UniversalScientificTechnologies/LABDOS01/fw/LABDOS/README.md

# Loading compiled binaries to MCU

## Avrdude

In case of using the avrdude and mightyCore bootloader we should use following command:

```
avrdude -v -patmega1284p -carduino -P/dev/ttyUSB0 -b115200 -D -Uflash:w:./build/MightyCore.avr.1284/LABDOS.ino.hex:i
```
