UniversalScientificTechnologies/LABDOS01/notebooks/spectrum_labdos.csv

 | energy | count
10 | 0.0429 | 21.074836950514023
11 | 0.0572 | 25.27985555842146
12 | 0.07150000000000001 | 45.40093592247319
13 | 0.08580000000000002 | 42.0720733999042
14 | 0.1001 | 34.35049191200855
15 | 0.1144 | 22.5532259847452
16 | 0.1287 | 17.705516047017205
17 | 0.14300000000000002 | 12.71056413279782
18 | 0.15730000000000002 | 9.889752754338774
19 | 0.1716 | 7.761376616677108
20 | 0.1859 | 7.25995799403073
21 | 0.20020000000000002 | 6.422270533181031
22 | 0.2145 | 5.119643317734626
23 | 0.2288 | 4.213640885810088
24 | 0.2431 | 4.372158148789564
25 | 0.2574 | 3.6525295699915254
26 | 0.2717 | 3.2817716201776044
27 | 0.286 | 2.7584656767014257
28 | 0.3003 | 2.816831865580898
29 | 0.3146 | 2.259036810494123
30 | 0.32889999999999997 | 2.2855668963484286
31 | 0.3432 | 1.8577692619477506
32 | 0.3575 | 1.7735362393603298
33 | 0.37179999999999996 | 1.5513467703305208
34 | 0.3861 | 1.4385939054497219
35 | 0.4004 | 1.2250267143225615
36 | 0.41469999999999996 | 1.1878845941265337
37 | 0.429 | 1.0612034341722245
38 | 0.44329999999999997 | 0.9623788643649361
39 | 0.4576 | 0.7992188363609566
40 | 0.4719 | 0.8025350970927447
41 | 0.48619999999999997 | 0.661925642064925
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
