UniversalScientificTechnologies/LABDOS01/notebooks/spectrum_tpx.csv

 | energy | count
0 | 0.01430052 | 19.723074776785715
1 | 0.028613320020491804 | 13.896271076224913
2 | 0.042926120040983604 | 10.928535686614524
3 | 0.05723892006147541 | 11.091536304604489
4 | 0.07155172008196722 | 20.277651592015943
5 | 0.08586452010245903 | 32.50644508190673
6 | 0.10017732012295082 | 32.99732050619835
7 | 0.11449012014344262 | 27.015634992375052
8 | 0.12880292016393444 | 20.348222740800868
9 | 0.14311572018442623 | 15.48943037313066
10 | 0.15742852020491804 | 12.155099723902993
11 | 0.17174132022540986 | 9.404698491612557
12 | 0.18605412024590162 | 7.645415959513972
13 | 0.20036692026639344 | 6.439461195764464
14 | 0.21467972028688526 | 5.36777897173849
15 | 0.22899252030737705 | 4.550277788026368
16 | 0.24330532032786886 | 3.9501107616341993
17 | 0.2576181203483607 | 3.476097470238096
18 | 0.27193092036885247 | 2.985222045946478
19 | 0.28624372038934426 | 2.662343427169422
20 | 0.3005565204098361 | 2.3013688785173163
21 | 0.3148693204303279 | 2.13399659644333
22 | 0.3291821204508197 | 1.884187220213499
23 | 0.3434949204713115 | 1.7236846959858325
24 | 0.35780772049180326 | 1.4944845932949629
25 | 0.37212052051229505 | 1.3439744441164898
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
