UniversalScientificTechnologies/LABDOS01/doc/EOSR7032-Edit.jpg

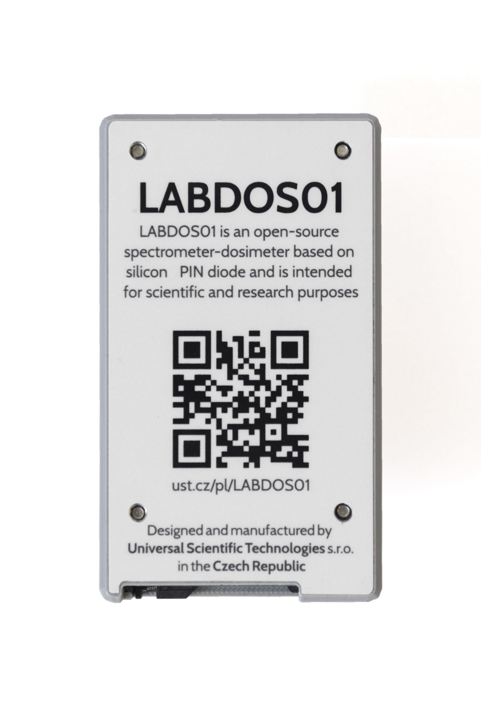
doc/EOSR7032-Edit.jpg
