UniversalScientificTechnologies/LABDOS01/doc/EOSR7036-Edit.jpg

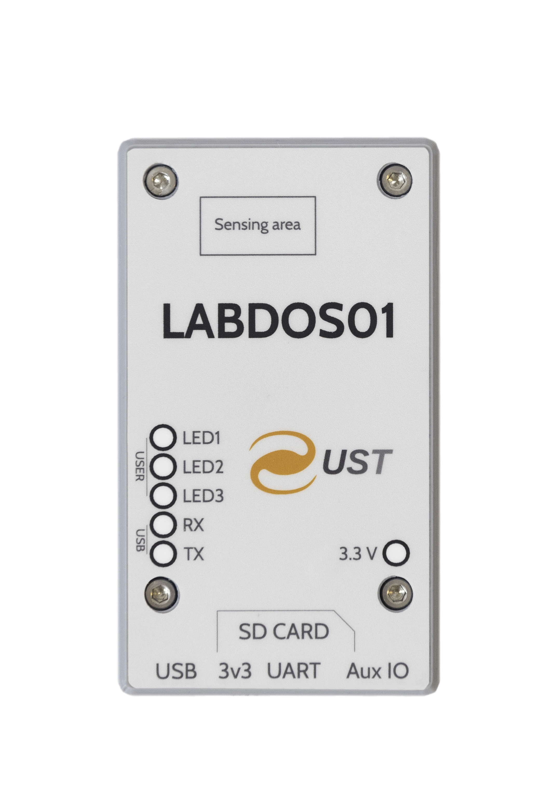
doc/EOSR7036-Edit.jpg
