UniversalScientificTechnologies/LABDOS01/doc/img/LABDOS01_cockpit.jpg

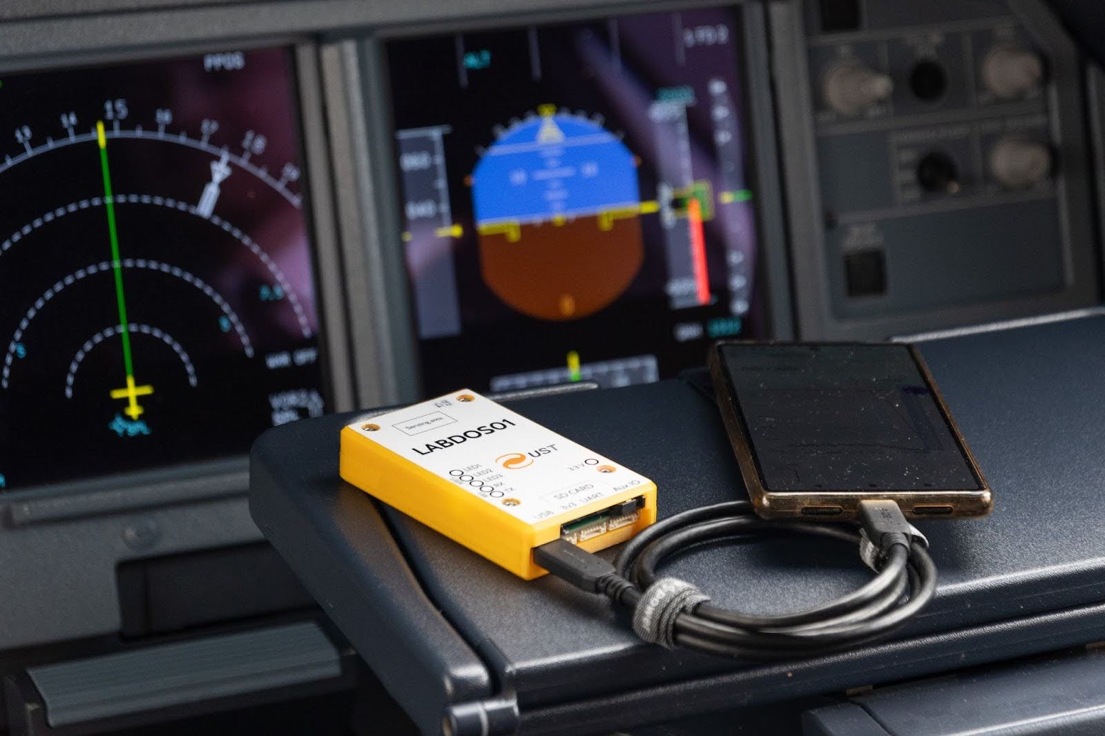
doc/img/LABDOS01_cockpit.jpg
