UniversalScientificTechnologies/LABDOS01/doc/LABDOS01A_merge.jpg

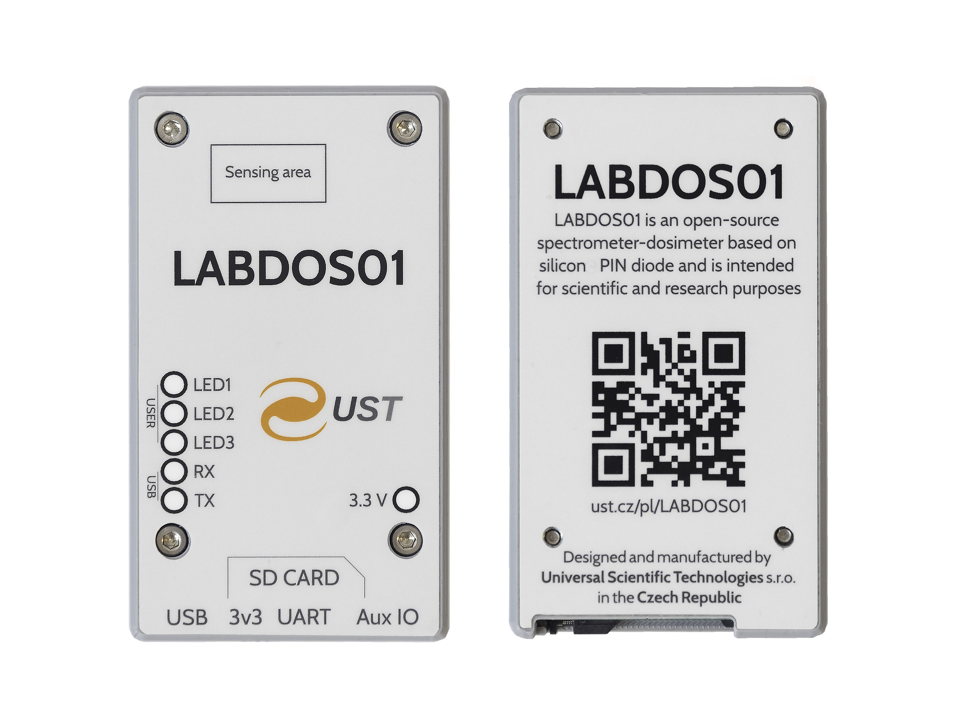
doc/LABDOS01A_merge.jpg
