UniversalScientificTechnologies/LABDOS01/cad/slice/case.3mf

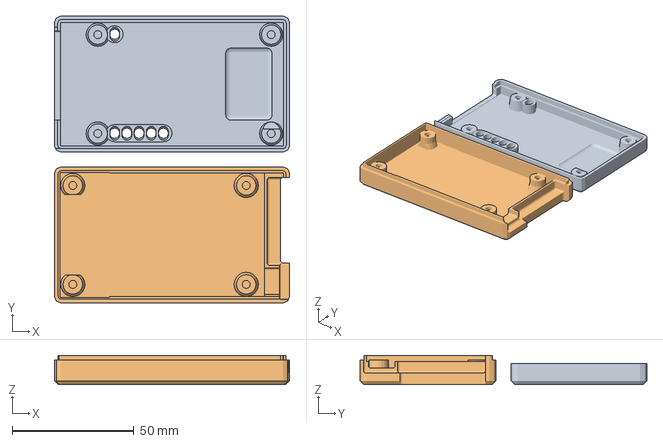
[picture p10: CAD file, 2023-12-08]
cad/slice/case.3mf
96.5 x 117.7 x 12.1 mm
case_top.stl
case_bot.stl
