UniversalScientificTechnologies/LABDOS01/cad/stl/case_top.stl

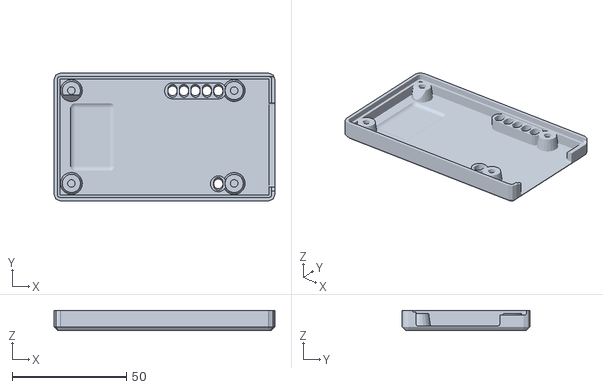
[picture p11: CAD file, 2023-04-22]
cad/stl/case_top.stl
96.5 x 55.8 x 8.76
