UniversalScientificTechnologies/LABDOS01/cad/slice/case_2x.3mf

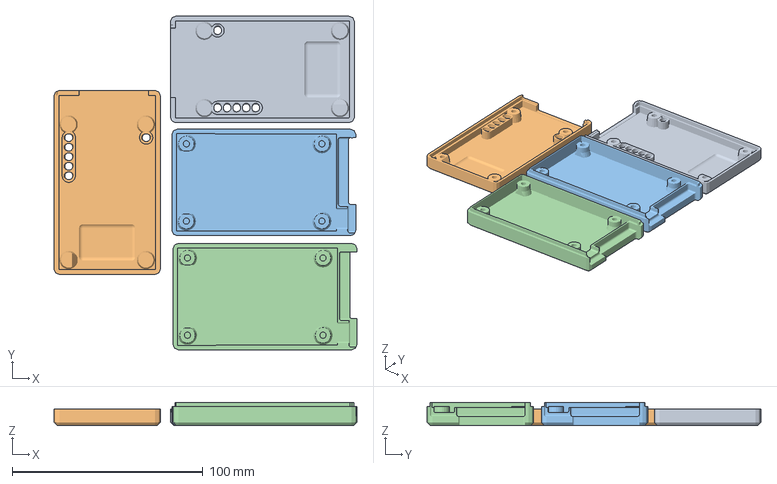
[picture p12: CAD file, 2023-04-22]
cad/slice/case_2x.3mf
159.0 x 175.0 x 12.1 mm
case_top.stl
case_bot.stl
