UniversalScientificTechnologies/LABDOS01/cad/stl/case_bot.stl

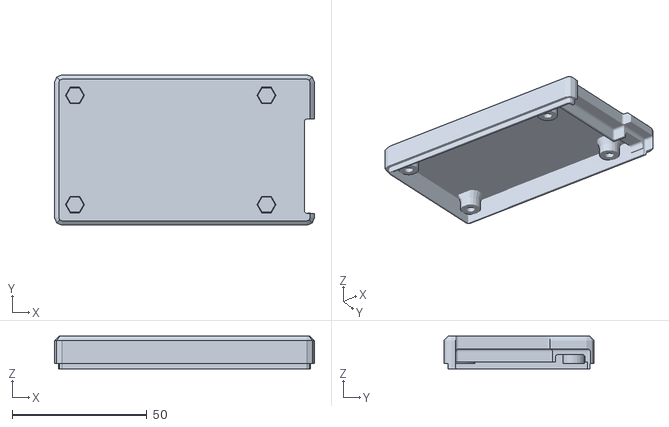
[picture p13: CAD file, 2023-04-22]
cad/stl/case_bot.stl
96.5 x 55.8 x 12.1
