UniversalScientificTechnologies/LABDOS01/cad/src/case_bot.scad

use <LABDOS01_case.scad>
rotate([180, 0, 0]) bot();
