UniversalScientificTechnologies/LABDOS01/cad/src/case_label_border.scad

use <LABDOS01_case.scad>

label();

translate([0, 70, 0]) label2();
