UniversalScientificTechnologies/LABDOS01/cad/src/case_top.scad

use <LABDOS01_case.scad>
rotate([180, 0, 0]) top();
