UniversalScientificTechnologies/LABDOS01/doc/calibration.ods

Sheet: Sheet1
 | LABDOS calibration |  | 1 pF | 3 pF | 4 pF | 5 pF
 | s.n. 7e
 |  |  |  |  | +-23 keV
C [F] | U [mV] | Q [C] | N_e | E [eV] | E [MeV] | ch |  | ch zaric | E zaric [MeV] |  |  | ch width
1.01E-12 | 239 | 2.4139E-13 | 1506803.99500624 | 5499834.58177278 | 5.49983458177278 | 201 | Am-241 | 201.5 | 5.486 | 0.329 | 14 | 0.0235
e [C] | 225 | 2.2725E-13 | 1418539.3258427 | 5177668.53932584 | 5.17766853932584 | 190 | Pu-239 | 190 | 5.157
1.60E-19 | 3.2 | 3.232E-15 | 20174.7815230961 | 73637.9525593009 | 0.0736379525593009 | 3
E_e-h | 3.1 | 3.131E-15 | 19544.3196004994 | 71336.7665418227 | 0.0713367665418227 | 3
3.65 | 253 | 2.5553E-13 | 1595068.66416979 | 5822000.62421973 | 5.82200062421973 | 207 | saturace
 | 239 | 2.4139E-13 | 1506803.99500624 | 5499834.58177278 | 5.49983458177278 | 97
 | 239 | 2.4139E-13 | 1506803.99500624 | 5499834.58177278 | 5.49983458177278 | 78
 | 624 | 6.3024E-13 | 3934082.39700375 | 14359400.7490637 | 14.3594007490637 | 207 | saturace
 | 730 | 7.373E-13 | 4602372.0349563 | 16798657.9275905 | 16.7986579275905 | 207 | saturace
 | 6.3 | 6.363E-15 | 39719.1011235955 | 144974.719101124 | 0.144974719101124 | 2
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
