UniversalScientificTechnologies/LABDOS01/(threads)

Thread 5 (2022-07-27):

Typo in bottom box sticker

kaklik, 2022-07-27:
There is accidentally [silicone](https://en.wikipedia.org/wiki/Silicone) instead of [silicon](https://en.wikipedia.org/wiki/Silicon):

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

At the same time, I suggest updating the text to describe better form: "LABDOS01 is an open-source spectrometer-dosimeter based on silicon PIN diode and is intended for scientific research and experimental purposes. "

roman-dvorak, 2022-09-26:
V návrhu samolepek opraveno:

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

Zároveň vyretušováno na všech fotkách v repozitáři.

Closed 2022-09-26.

Thread 6 (2022-10-20):

Design consistency

kaklik, 2022-10-20:
Současné řešení je navrženo tak moc "univerzálně", že některé jeho vlastnosti nelze využít. Například JST-GH konektor původně určený pro bateriové napájení je obtížně použitelný.
Zároveň je zde příprava pro připojení [TFGPS01](https://github.com/ThunderFly-aerospace/TFGPS01), která ale nejde použít jinak než s powerbankou, která má dva napájecí konektory.  Příčinou je, že LABDOS zároveň předpokládá použití jako payloadu pro UAV. V takové aplikaci se pak předpokládá, že GPS bude napájena z jiného zdroje.
UART konektor je proto chráněn diodou tak, aby se na něj nemohlo dostat napájecí napětí z případně zapojeného USB konektoru, což by způsobilo nechtěné napájení celého UAV systému. USB konektor je ale na LABDOSu podstatný proto, aby zařízení mohlo být kompaktní a snadno použitelné pro různé laboratorní aplikace.

Z těchto důvodů bych navrhoval použití LABDOSu jako UAV payloadu zrušit a tuto vlastnost pokrýt [původně zamýšlenou úpravou SPACEDOS02](https://github.com/UniversalScientificTechnologies/SPACEDOS02/issues), který nemá mít USB konektor a konektor pro napájení z baterie. Tyto dva konektory jsou příčinou zmíněných komplikací.

Naopak dává smysl současnou dvojici UART konektoru a "bateriového napájecího konektoru" na LABDOSu nahradit [Autopilot GPS&SAFETY connectorem](https://github.com/ThunderFly-aerospace/TFGPS01#autopilot-gpssafety-connector). Což umožní připojit TFGPS stejně jako se připojuje k autopilotu, což kromě napájení umožní i další možnosti:

- Připojení externího pípáku z TFGPS
- Připojení tlačítka
- Připojení výstupu z GPS
- Možnost připojení nějakých podpůrných čidel na I2C sběrnici.

Na zvážení je také odebrání pouzdra pro SDkartu, které v zařízení, které je napájeno z USB konektoru připojeného do nadřazeného systému nedává úplně smysl.
Taktéž RTC obvod a jeho baterie asi nedává smysl.

Thread 7 (2022-10-21):

Sticker screw hole possitions

kaklik, 2022-10-21:
Samolepky se při skladování zřejmě scvrkly a otvory na hlavičky šroubů nyní nepasují přesně na šrouby. Tím dochází k zakrývání hlaviček šrubů.
Podezřelé ale je, že se tento problém zřejmě vyskytuje už od nových samolepek. Před výrobou dalších je třeba ověřit, že otvory výřezů pro šrouby z vrchní strany jsou skutečně správně umístěny.

roman-dvorak, 2022-10-21:
z PDF návrhu jsem změřil, že rozteč otvorů na šrouby v horní vrstvě je:

 * 71,122 mm  ->  10.16*7 je 71.2
 * 40.59 mm  ->  10.16*4 je 40.64

Bylo by zajímavé porovnat vzdálenosti otvorů od kraje samolepky.

Pozice děr vznikla způsobem, že jsem z openscadu si vytvořil projekci
krabičky a ta byla vzata jako obrys pro samolepku.
Message ID: ***@***.***

>

kaklik, 2022-11-11:
Zřejmě to tak není problém návrhu ale výroby samolepky..

Thread 9 (2023-01-20):

Reset button

kaklik, 2023-01-20:
Pro experimenty s firmwarem je celkem podstatné mít možnost číst  data na sériové lince od okamžiku spuštění MCU. U LABDOSu s připojením na USB, se to ale těžko dělá, protože MCU dovede zapisovat data do virtuálního USB serial ještě dříve, než se zinicializuje.

Řešením tohoto problému by bylo přidání resetovacího tlačítka, které lze zmáčknout otvorem v krabičce pomocí nějakého nástroje.

kaklik, 2023-01-23:
Altenrantivním řešením může být zatahání za DTR. Například picocom by to měl umět pomocí klávesových zkratek Ctrl+A Ctrl+P.

Thread 11 (2023-02-17):

Merge the firmware variants to streamline codebase

kaklik, 2023-02-17:
Současný firmware má několik různých variant, které se jen minimálně liší:

- Počtem kanálů 256/512
- Jestli má nebo nemá SDkartu pro zápis
- Frekvencí použitého krystalu

U těchto rozdílů zřejmě neexistuje důvod proč držet různé codebase.  Zádrhelem je akorát to, že by bylo potřeba implementovat přepínací vlastnosti firmware (což je ale stejně potřeba kvůli integračnímu intervalu). Tyto parametry jsou buď nastaveny při překladu (frekvence krystalu), nebo jsou parametrem přístroje (počet kanálů, integrační doba, zápis na SDkartu...)

Parametry přístroje by zřejmě správně měly být zapisovány do externí EEPROM, aby nebyly přepsány aktualizací firmware.

-------
**Poznámka k počtu kanálů**
Původní verze detektoru měla pouze 256 kanálů jako liulin.  Zvětšení počtu kanálů podle @kakl  vedlo na problem, ze ta ATmega ma nejakou proprietarni kompenzaci DC offsetu. Díky tomu interní ADC nefunguje dobře s externí referencí a způsobuje to jitter kanálů na spektrogramu. https://github.com/UniversalScientificTechnologies/LABDOS01/issues/15

Počet kanálů by ale obecně potřeboval zvýšit viz https://github.com/UniversalScientificTechnologies/GEODOS01/issues/23 Tudíž je zřejmě nutné začít používat externí ADC.

kaklik, 2023-04-21:
Tohle bylo provedeno až na firmware pro "UAVDOS", který zde zatím zůstal.

Closed 2023-04-21.

Thread 13 (2023-02-17):

Dead time minimalization

kaklik, 2023-02-17:
Aktuální implementace minimalizuje mrtvou měřící dobu tím způsobem, že hromadí co nejvíce dat v operační paměti a z nich pak vytvoří datovou zprávu kterou buď rychle odešle na UART, nebo [uloží na SDkartu](https://github.com/UniversalScientificTechnologies/GEODOS01/issues/24).

Takový přístup je do značné míry suboptimální, protože jednak neminimalizuje mrtvou dobu měření úplně a zároveň ji prodlužuje na těžko definovanou dobu, která závisí na měřených datech.

Navíc to komplikuje zacházení s formátem výstupních dat https://github.com/UniversalScientificTechnologies/LABDOS01/issues/12

Teoreticky by ale mrtvou dobu mělo jít výrazně omezit vhodnou obsluhou UART. Protože, jednak lze nastavit různou délku bufferu pro UART. Například bootloader pro mightycore má [tyhle flagy](https://github.com/MCUdude/MightyCore/blob/master/PlatformIO.md#build_flags), které tu velikost bufferu řídí. Velikost bufferu 128 bytes by měla stačit na většinu zpráv, kromě spektrogramů, které se posílají jen zřídka. Navíc u spektrogramů by možná bylo žádoucí, aby zprávy byly nějak komprimovány, protože zpráva spektrogramu obsahuje většinou samé nuly.

Zároveň by mělo být možné UART obsluhovat v časech, kdy probíhá ADC převod. Protože při vzorkování ADC 125 us má MCU při 8 MHz k dispozici 1000 instrukcí mezi každou hodnotou ADC. Za tu dobu může být odesláno celých 14 bitů na UART rychlostí 115200.
