UniversalScientificTechnologies/LABDOS01/fw/LABDOS/githash.h

// This file is overwritten by github actions, do not update it manually
String githash = "cbacfbdd65d43bef95dcc19c1a2bed90ff005a38,User";
#define GHRELEASE 5
#define GHBUILD 0
#define GHBUILDTYPE User
