UniversalScientificTechnologies/LABDOS01/fw/UAVDOS/githash.h

// This file is overwritten by github actions, do not update it manually
String githash = "982ca03bf1ce16e72879a7862f0255dc6489c66e,User";
#define GHRELEASE 4
#define GHBUILD 0
#define GHBUILDTYPE User
