UniversalScientificTechnologies/LABDOS01/(commit log)

2022-04-12 add pcb reference
2022-06-09 add case files
    [SPACEDOS03_case.scad, case_bot.scad, case_bot.stl, case_top.scad, case_top.stl]
2022-06-11 motiv stitku, vygenerovani hranice z openscadu
    [SPACEDOS03_case.scad, case_label_border.scad]
2022-06-19 pridani vyrezu pro konektory
    [SPACEDOS03_case.scad, case_label_border.scad]
2022-06-30 Update output structure, remove relay
2022-07-08 Update PCB submodule.
2022-08-06 averaging of DCoffset
    [calibration.ods]
2022-08-31 512 CH version
    [calibration.ods]
2022-10-19 Make PrusaSlicer project from existing STLs.
    [case_printplate.3mf]
2022-10-22 Maximal calibration errors
2023-01-20 Switch firmware to 8MHz crystal setup.
2023-02-16 new filtering algorithm solving double detection
2023-02-21 correction of bug, too long waiting for S/H
    [LABDOS.ino]
2023-02-23 bad value in ADC prescaller for 8 MHz version
2023-02-23 bad value in ADC prescaller for 8 MHz version, extended build
2023-02-24 fix typo, extended build
    [githash.h]
2023-02-24 add UAVDOS to compile matrix with own versions. Lots of paths will need fix.
    [UAVDOS.ino]
2023-02-25 try to fix build with correct version strig
    [LABDOS.ino]
2023-02-25 try to fix build with correct version strig, extended build
    [githash.h]
2023-02-25 fix LABDOS version string
    [LABDOS.ino]
2023-02-25 fix LABDOS version string, extended build
    [githash.h]
2023-02-25 fix LABDOS version string, extended build, extended build
    [githash.h]
2023-02-25 fix LABDOS version string, extended build, extended build, extended build
    [githash.h]
2023-04-01 Adding gcode used for case printing.
2023-04-13 old filter revival
2023-04-20 aktualizace krabicky, reseni #10
    [LABDOS01_case.scad, SPACEDOS03_case.scad, case.3mf, case_2x.3mf, case_bot.scad, case_bot.stl, case_label_border.scad, case_printplate.3mf]
2023-05-05 Create tindie.md
    Committing the current state of Tindie product listing.
2023-08-03 Attempt to resolve #10
    [case.3mf]
2023-09-01 Update README.md
    Correct the PIN diode detection volume.
2023-09-01 Update tindie.md
    Correct detection volume of PIN diode.
2023-11-24 eternal voltage reference
2023-11-24 eternal voltage reference, extended build
2023-11-25 Add files via upload
    Transparent openings for LEDs added.
2023-11-26 pridani kicad vrstev do SVG souboru
2023-12-08 Reslice with prusa IS.
    [case.3mf]
2023-12-08 Change slice profile to structural.
    [case.3mf]
2023-12-08 version for LABDOS01B with external voltage reference
2023-12-08 version for LABDOS01B with external voltage reference, extended build
2024-02-23 porovnani mereni na LS
    [spectrum_labdos.csv, spectrum_tpx.csv]
2024-02-24 rebinned to LABDOS's chanell width
    [spectrum_labdos.csv, spectrum_tpx.csv]
